EmbeddedSystemClass/dynamometer/README.md

# dynamometer
Electric winch two motor testing 

Two motors are coupled via a Gates belt.  One motor operates in torque mode and the other acts as a regenerative brake in speed mode.  The battery bank supplies power to make up for losses.  Other instrumentation measures drive belt tension, and inverter currents, etc.

This project clones many of the routines developed in the 'mxusartusbcan' project, and uses STM32CubeMX with FreeRTOS on a DiscoveryF4 board connected to other hardware interfaces.
