EmbeddedSystemClass/dynamometer/Ourwares/adcsetup.ods

 | mxusartusbcan |  | From datasheet formula
 | adc setup |  | Section | 5.3.21
 | 02/02/19 |  | 12-bit ADC | characteristics
 |  | Bus | 84
 |  | Divider | 8
 | K(sampling) | C(pf) | fadc*MHz) | 12bit | Rain |  | Sample tiime
 | 3 | 5 | 10.5 | 9.7040605278 | 5.79 |  | 0.3
 | 15 | 5 | 10.5 | 9.7040605278 | 29.34 |  | 1.4
 | 28 | 5 | 10.5 | 9.7040605278 | 54.86 |  | 2.7
 | 56 | 5 | 10.5 | 9.7040605278 | 109.82 |  | 5.3 |  |  | cts/volt
 | 84 | 5 | 10.5 | 9.7040605278 | 164.78 |  | 8.0 |  |  | 819 | 2.5 | 2047.5 | 2047.5
 | 112 | 5 | 10.5 | 9.7040605278 | 219.74 |  | 10.7 |  |  |  | 2047 | 1842.3
 | 144 | 5 | 10.5 | 9.7040605278 | 282.55 |  | 13.7
dynamometer | 480 | 5 | 10.5 | 9.7040605278 | 942.07 |  | 45.7
'MX
03/15/19 |  |  | ADC | Sample cycles | conv (us) |  |  | Offset | divider | Sensor amps | scale
 | PA1 | IN1 | 1 | 56 | 6.4761904762 |  | spare | ADC cts |  |  | amps
 | PA5 | IN5 | 2 | 56 | 6.4761904762 |  | Total battery current | 2047 | 0.6444444444 | 200 | 0.1086 |  | ACS770ECB-200B-PFF-T
 | PA6 | IN6 | 3 | 56 | 6.4761904762 |  | Current #1 motor | 2047 | 0.6444444444 | 600 | 0.3257 |  | L01Z600S05
 | PA7 | IN7 | 4 | 56 | 6.4761904762 |  | Current #2 motor | 2047 | 0.6444444444 | 400 | 0.2172 |  | L01Z400S05
 | PB0 | IN8 | 5 | 56 | 6.4761904762 |  | Speed control pot
 | PC1 | IN11 | 6 | 56 | 6.4761904762 |  | Control level (Hall sensor)
 | PC2 | IN12 | 7 | 56 | 6.4761904762 |  | +12 volt supply raw | 0 | 0.1525423729 | 19.0111111111
 | PC5 | IN15 | 8 | 56 | 6.4761904762 |  | +5 sensor supply voltage | 0 | 0.5465116279 | 5.3063829787
 |  | Temp | 9 | 480 | 46.8571428571 |  | Internal temperature sensor
 |  | Vref | 10 | 480 | 46.8571428571 |  | Internal voltage reference
 |  |  | DMA buffer | Num seq | 16
 |  |  |  | Total size | 320 |  |  | 10 | 10 | 0.5000 | 2.5000
 |  |  |  |  |  |  |  | 8.2 | 10 | 0.5495 | 2.7473
 |  |  |  | Time per seq | 145.5238095238 |  |  | 6.8 | 10 | 0.5952 | 2.9762
 |  |  | DMA buffer | Num seq | 16 | Per ½ dma
 |  |  |  | Per dma | 2328.380952381 | 1164.1904761905
 |  |  |  |  | 858.9659685864
 |  |  |  |  | DMA interrupt
 |  |  |  |  | Per sec | us per
 |  |  |  |  | 859 | 1164.1443538999
