EmbeddedSystemClass/dynamometer/docs/manuals/DMOC Boot Information.docx

DMOC Boot Information

EEBoxConfig: CRC OK. Versions Match.

CBL-51NA-3041-001

EE Parameters: CRC OK. GUID match OK.

EE3 (Vars): CRC OK. GUID match OK.

EEBoxConfig: CRC OK. Versions Match.

Control at 1x switching frequency (10kHz).

Azure Transit Connect MY10.5 645 Liquid Cooled, Siemens 1PV5135

P1X-18FB-3047-010 Fri Oct 28 16:07:19 2011

Compiled by zsobhani from b_rel_0032 at R21756+

Hardware PN: CTR-010180-00K SN: 111018-006

GUID: 9D-C7-1C-F3-A0-B7-42-DD

DMoC Time is: 2018/05/31 22:52:57 GMT

................"""""""""""""""""""""""""""""""""


NOTE: DMOC serial parameters are 19200 8N1

Note the GUID is the same as for my first DMOC
