EmbeddedSystemClass/dynamometer/docs/schematics/CP State LEDs.sch

## EAGLE design docs/schematics/CP State LEDs.sch (2019-03-12)

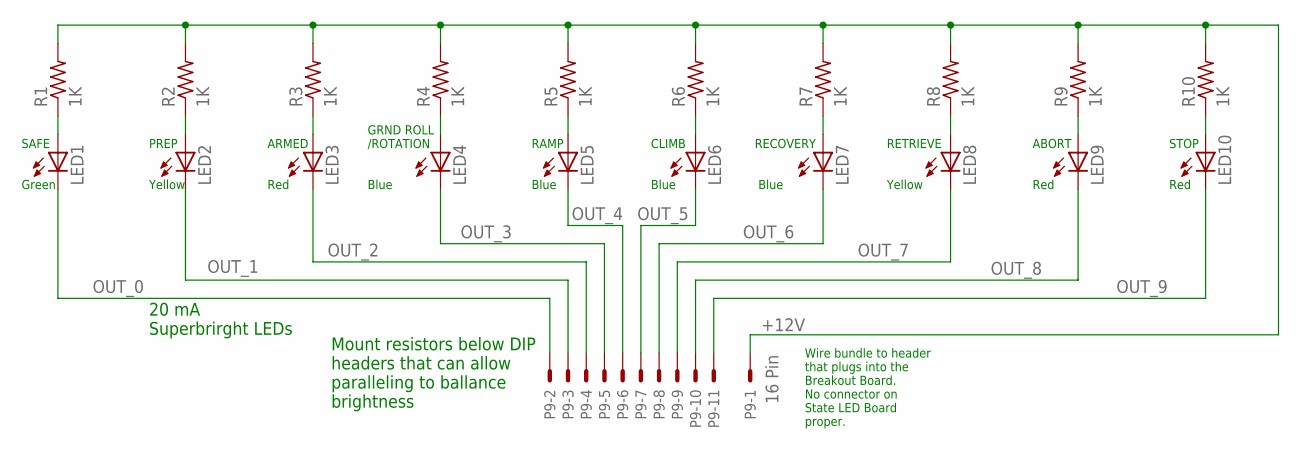
[picture p1: schematic CP State LEDs.sch]

Parts:
LED1, LED2, LED3, LED4, LED5, LED6, LED7, LED8, LED9, LED10: LED5MM
P9: 16 Pin; 70543-20
R1, R2, R3, R4, R5, R6, R7, R8, R9, R10: 1K; V234/12

Connections:
+12V: P9.1, R1.2, R2.2, R3.2, R4.2, R5.2, R6.2, R7.2, R8.2, R9.2, R10.2
unnamed: LED1.A, R1.1
unnamed: LED2.A, R2.1
unnamed: LED3.A, R3.1
unnamed: LED4.A, R4.1
unnamed: LED5.A, R5.1
unnamed: LED6.A, R6.1
unnamed: LED7.A, R7.1
unnamed: LED8.A, R8.1
unnamed: LED9.A, R9.1
unnamed: LED10.A, R10.1
OUT_0: LED1.K (C), P9.2
OUT_1: LED2.K (C), P9.3
OUT_2: LED3.K (C), P9.4
OUT_3: LED4.K (C), P9.5
OUT_4: LED5.K (C), P9.6
OUT_5: LED6.K (C), P9.7
OUT_6: LED7.K (C), P9.8
OUT_7: LED8.K (C), P9.9
OUT_8: LED9.K (C), P9.10
OUT_9: LED10.K (C), P9.11

Notes on the sheet:
SAFE Green
PREP Yellow
ARMED Red
GRND ROLL /ROTATION Blue
RAMP Blue
CLIMB Blue
RECOVERY Blue
RETRIEVE Yellow
ABORT Red
STOP Red
20 mA Superbrirght LEDs
Mount resistors below DIP headers that can allow paralleling to ballance brightness
Wire bundle to header that plugs into the Breakout Board. No connector on State LED Board proper.
