EmbeddedSystemClass/dynamometer/docs/schematics/Control Panel High Level.sch

## EAGLE design docs/schematics/Control Panel High Level.sch (2019-03-12)

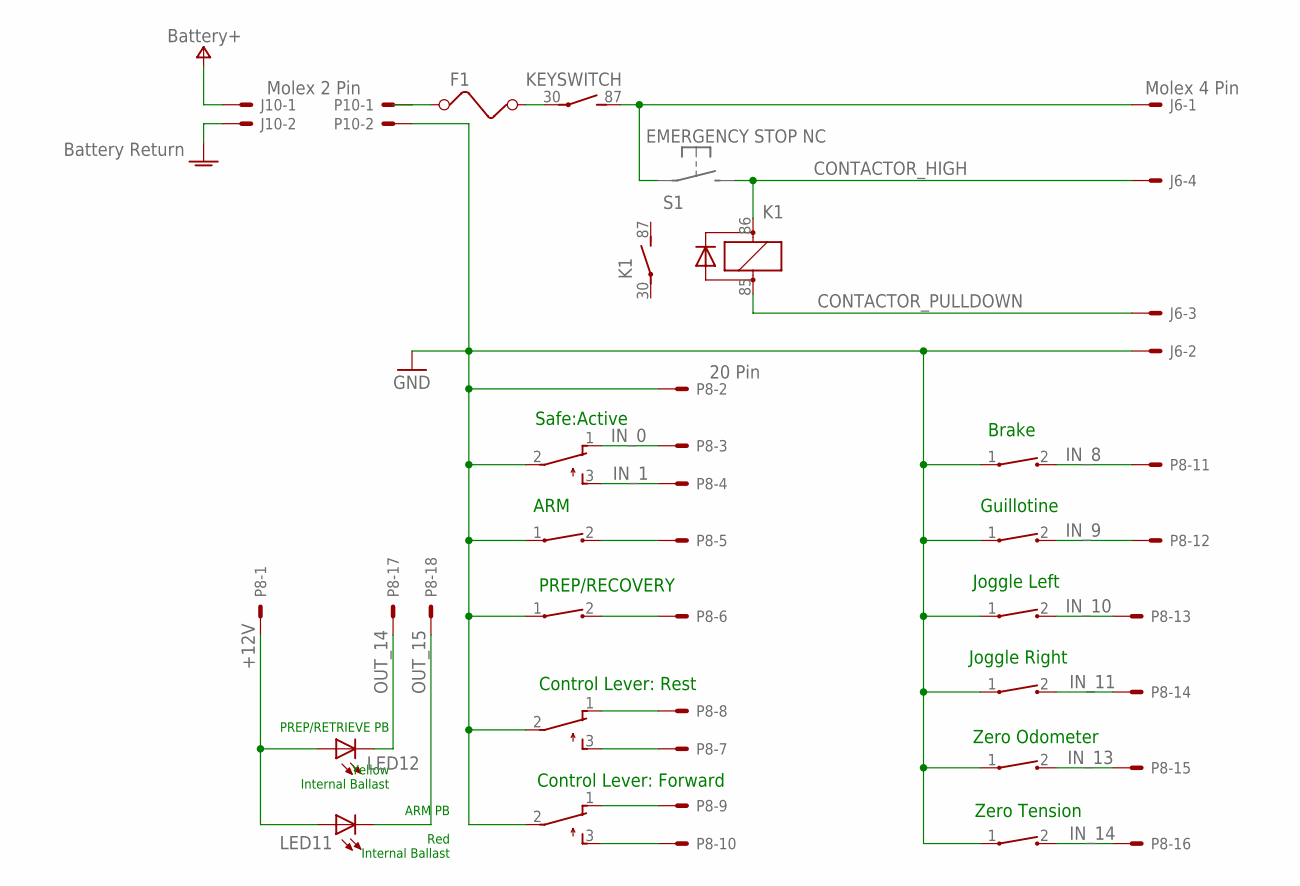
[picture p2: schematic Control Panel High Level.sch]

Parts:
F1: FUSE
J6: Molex 4 Pin; 22-23-2041
J10: 22-23-2021
K1: CB1-D-P-12V; CB1
KEYSWITCH: Starter Relay; CB1
LED11, LED12: LED5MM
P8: 20 Pin; 70543-20
P10: Molex 2 Pin; 22-23-2021
S2, S3, S8: TL32PO; TL3XPO
SW1, SW2, SW3, SW4, SW7, SW8, SW9, SW10: CT10-XXXX-A2

Connections:
+12V: LED11.A, LED12.A, P8.1
BATTERY+: J10.1
CONTACTOR_HIGH: J6.4, K1.86 (+)
CONTACTOR_PULLDOWN: J6.3, K1.85 (-)
GND: J6.2, P8.2, P10.2, S2.2, S3.2, S8.2, SW1.1, SW2.1, SW3.1, SW4.1, SW7.1, SW8.1, SW9.1, SW10.1
GNDA: J10.2
IN_0: P8.3, S8.1 (O)
IN_1: P8.4, S8.3 (S)
IN_8: P8.11, SW7.2
IN_9: P8.12, SW8.2
IN_10: P8.13, SW9.2
IN_11: P8.14, SW10.2
IN_13: P8.15, SW2.2
IN_14: P8.16, SW1.2
unnamed: F1.2, KEYSWITCH.30
unnamed: J6.1, KEYSWITCH.87 (S)
unnamed: F1.1, P10.1
unnamed: P8.10, S3.3 (S)
unnamed: P8.9, S3.1 (O)
unnamed: P8.8, S2.1 (O)
unnamed: P8.7, S2.3 (S)
unnamed: P8.6, SW4.2
unnamed: P8.5, SW3.2
OUT_14: LED12.K (C), P8.17
OUT_15: LED11.K (C), P8.18

Notes on the sheet:
Control Lever: Forward
Control Lever: Rest
PREP/RECOVERY
ARM
Zero Odometer
Zero Tension
Joggle Left
Joggle Right
Brake
Guillotine
Safe:Active
ARM PB Red Internal Ballast
PREP/RETRIEVE PB Yellow Internal Ballast
