EmbeddedSystemClass/dynamometer/docs/schematics/MC Breakout-F4 & Power.sch

## EAGLE design docs/schematics/MC Breakout-F4 & Power.sch (2019-03-12)

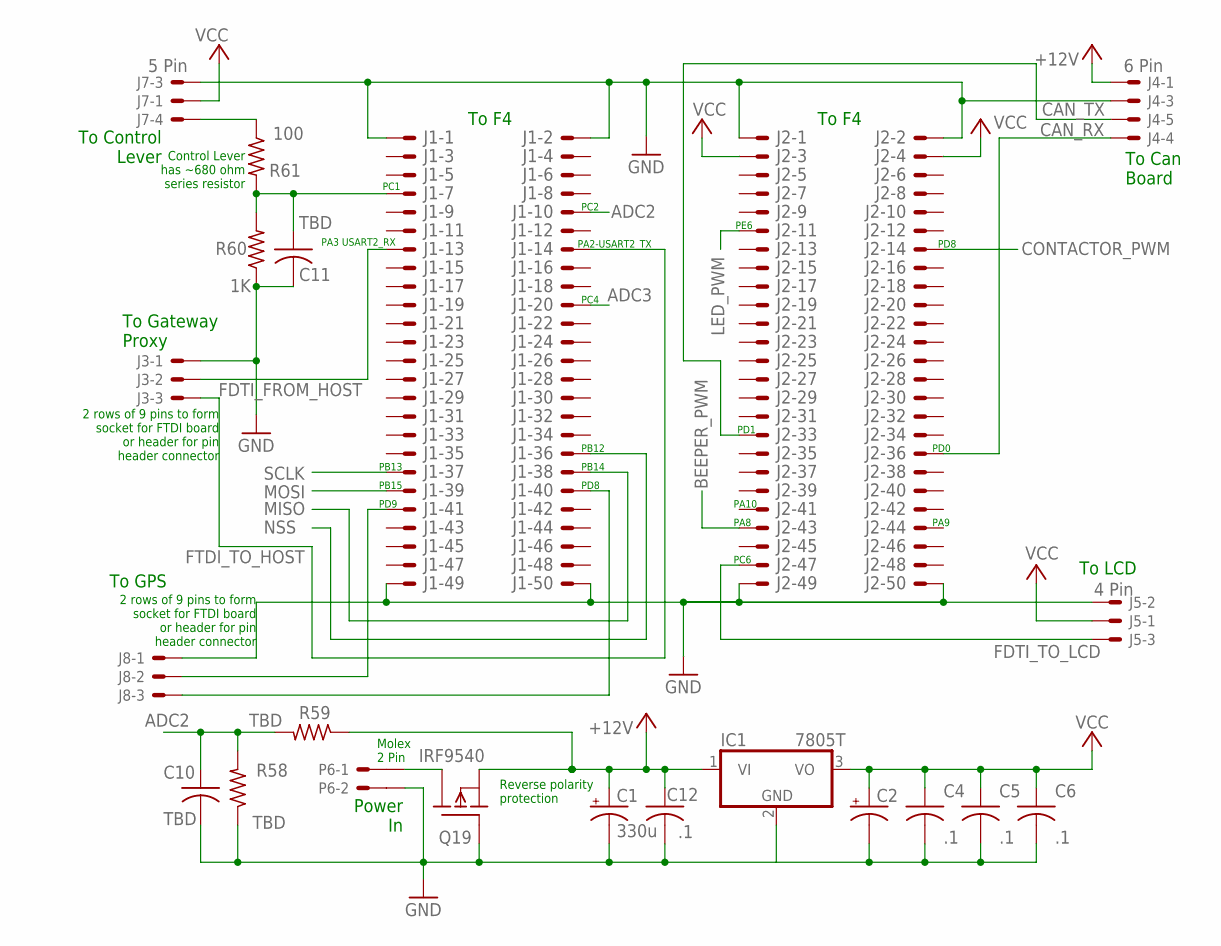
[picture p3: schematic MC Breakout-F4 & Power.sch]

Parts:
C1: 330u; E2-5
C2: CPOL-USE2-5; E2-5
C4, C5, C6, C12: .1; SMT0805
C10, C11: TBD; SMT0805
IC1: 7805T; TO220H
J1, J2: 1365-50
J3, J8: 22-23-2041
J4: 6 Pin; 22-23-2061
J5: 4 Pin; 22-23-2051
J7: 5 Pin; 22-23-2051
P6: 43160-3102; 43160-XX02
Q19: IRF9540; TO220
R58, R59: TBD; V234/12
R60: 1K; V234/12
R61: 100; V234/12

Connections:
+5V: C1.+, C12.P$1 (1), IC1.1 (VI), J4.1, Q19.3 (S), R59.1
ADC2: C10.P$1 (1), J1.10, R58.2, R59.2
ADC3: J1.20
ADC_1: C11.P$1 (1), J1.7, R60.2, R61.2
BEEPER_PWM: J2.43
CAN_RX: J2.36, J4.4
CAN_TX: J2.33, J4.5
CONTACTOR_PWM: J2.14
CONTROL_LEVER: J7.4, R61.1
FDTI_FROM_HOST: J3.3
FDTI_FROM_HOST1: J1.40, J8.3
FDTI_TO_LCD: J2.47, J5.3
FLYBACK_RTN: P6.1@1, Q19.2 (D)
FTDI_TO_HOST: J3.2
FTDI_TO_HOST1: J1.41, J8.2
GND: C1.-, C2.-, C4.P$2 (2), C5.P$2 (2), C6.P$2 (2), C10.P$2 (2), C11.P$2 (2), C12.P$2 (2), IC1.2 (GND), J1.1, J1.2, J1.49, J1.50, J2.1, J2.2, J2.49, J2.50, J3.1, J4.3, J5.2, J7.3, J8.1, P6.2@1, Q19.1 (G), R58.1, R60.1
LED_PWM: J2.11
MISO: J1.38
MOSI: J1.39
NSS: J1.36
SCLK: J1.37
VCC: C2.+, C4.P$1 (1), C5.P$1 (1), C6.P$1 (1), IC1.3 (VO), J2.3, J2.4, J5.1, J7.1

Notes on the sheet:
To F4
To Can Board
To Gateway Proxy
To Control Lever
To LCD
Power In
Molex 2 Pin
Reverse polarity protection
Control Lever has ~680 ohm series resistor
PB13
PC1
PB15
PB14
PD8
PA8
PA10
PA9
PC4
PC2
PD0
PE6
PD1
PA2-USART2_TX
PA3 USART2_RX
PD9
PC6
To GPS
2 rows of 9 pins to form socket for FTDI board or header for pin header connector
PB12
