EmbeddedSystemClass/dynamometer/docs/schematics/MC Brekout-SPInew.sch

## EAGLE design docs/schematics/MC Brekout-SPInew.sch (2019-03-12)

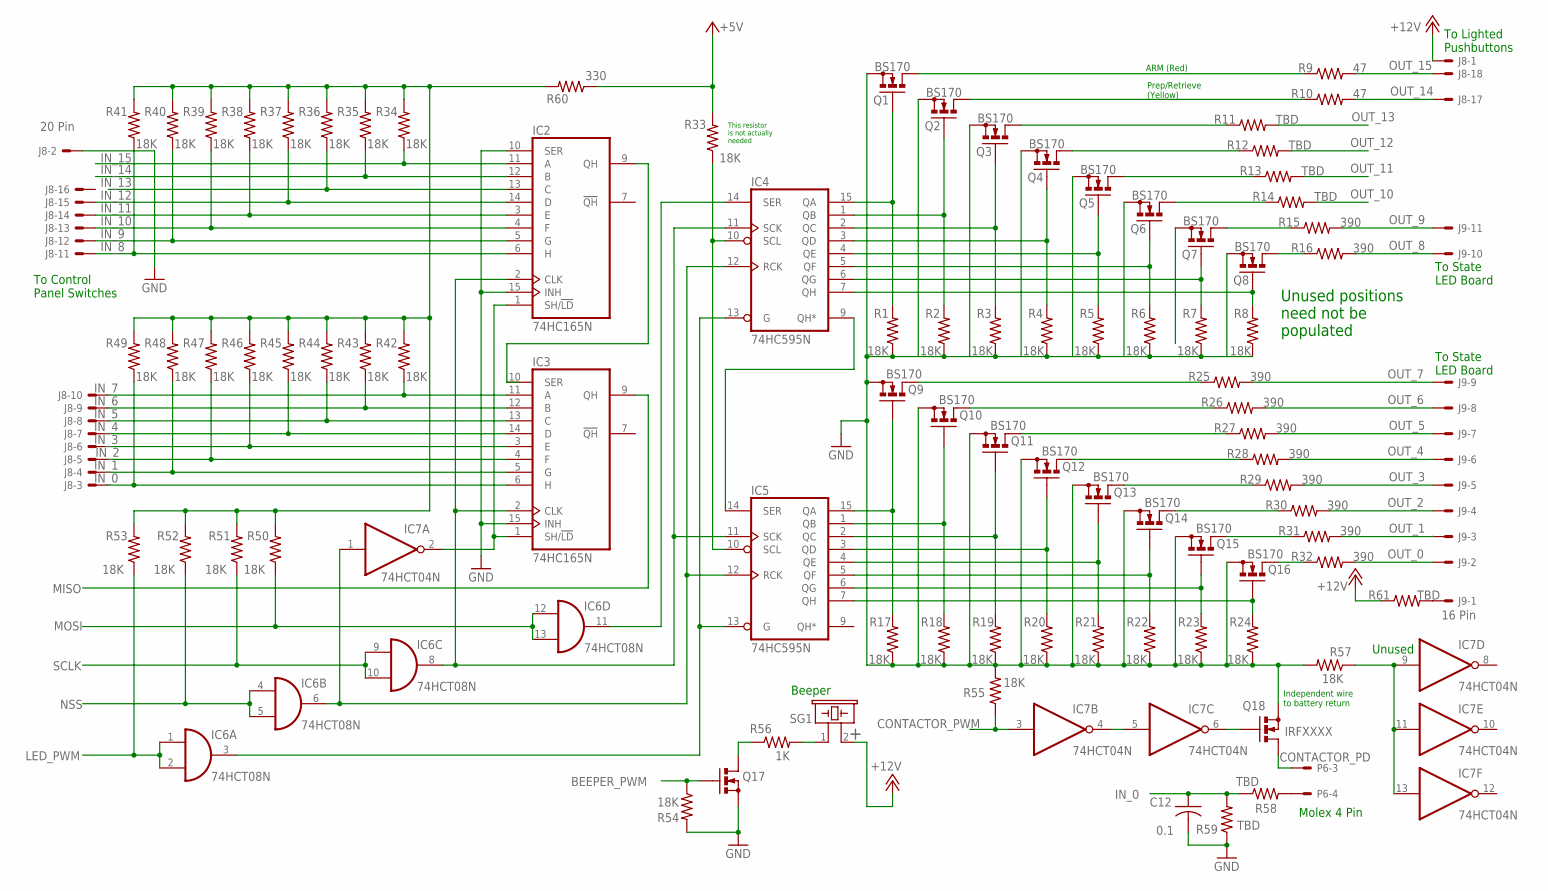
[picture p4: schematic MC Brekout-SPInew.sch]

Parts:
C12: 0.1; SMT0805
IC2, IC3: 74HC165N; DIL16
IC4, IC5: 74HC595N; DIL16
IC6: 74HCT08N; DIL14
IC7: 74HCT04N; DIL14
J8: 20 Pin; 70543-20
J9: 16 Pin; 22-23-2121
P6: Molex 4 Pin; 22-23-2041
Q1, Q2, Q3, Q4, Q5, Q6, Q7, Q8, Q9, Q10, Q11, Q12, Q13, Q14, Q15, Q16, Q17: BS170; SOT54E
Q18: IRFXXXX; SOT54E
R1, R2, R3, R4, R5, R6, R7, R8, R17, R18, R19, R20, R21, R22, R23, R24, R33, R34, R35, R36, R37, R38, R39, R40, R41, R42, R43, R44, R45, R46, R47, R48, R49, R50, R51, R52, R53, R54, R55, R57: 18K; V234/12
R9, R10: 47; V234/12
R11, R12, R13, R14, R58, R59, R61: TBD; V234/12
R15, R16, R25, R26, R27, R28, R29, R30, R31, R32: 390; V234/12
R56: 1K; V234/12
R60: 330; V234/12
SG1: EFBAA40D101

Connections:
+5V: R33.2, R60.1
+12V: J8.1, R61.1, SG1.2
BEEPER_PWM: Q17.G, R54.1
CONTACTOR_PD: P6.3, Q18.D
CONTACTOR_PWM: IC7.3 (I), R55.1
GND: C12.P$2 (2), IC2.10 (SER), IC2.15 (INH), IC3.15 (INH), J8.2, Q1.S, Q9.S, Q10.S, Q11.S, Q12.S, Q13.S, Q14.S, Q15.S, Q16.S, Q17.S, Q18.S, R1.1, R2.1, R3.1, R4.1, R5.1, R6.1, R7.1, R8.1, R17.1, R18.1, R19.1, R20.1, R21.1, R22.1, R23.1, R24.1, R54.2, R55.2, R57.2, R59.1
IN_0: C12.P$1 (1), IC3.6 (H), J8.3, R49.1, R58.1, R59.2
IN_1: IC3.5 (G), J8.4, R48.1
IN_2: IC3.4 (F), J8.5, R47.1
IN_3: IC3.3 (E), J8.6, R46.1
IN_4: IC3.14 (D), J8.7, R45.1
IN_5: IC3.13 (C), J8.8, R44.1
IN_6: IC3.12 (B), J8.9, R43.1
IN_7: IC3.11 (A), J8.10, R42.1
IN_8: IC2.6 (H), J8.11, R41.1
IN_9: IC2.5 (G), J8.12, R40.1
IN_10: IC2.4 (F), J8.13, R39.1
IN_11: IC2.3 (E), J8.14, R38.1
IN_12: IC2.14 (D), J8.15, R37.1
IN_13: IC2.13 (C), R36.1
IN_14: IC2.12 (B), R35.1
IN_15: IC2.11 (A), R34.1
LED_PWM: IC6.1 (I0), IC6.2 (I1), R53.1
MISO: IC3.9 (QH)
MOSI: IC6.12 (I0), IC6.13 (I1), R50.1
unnamed: P6.4, R58.2
unnamed: IC4.1 (QB), Q2.G, R2.2
unnamed: IC4.2 (QC), Q3.G, R3.2
unnamed: IC4.3 (QD), Q4.G, R4.2
unnamed: IC4.4 (QE), Q5.G, R5.2
unnamed: IC5.1 (QB), Q10.G, R18.2
unnamed: IC4.6 (QG), Q7.G, R7.2
unnamed: IC4.7 (QH), Q8.G, R8.2
unnamed: Q1.D, R9.1
unnamed: Q2.D, R10.1
unnamed: Q3.D, R11.1
unnamed: Q4.D, R12.1
unnamed: Q5.D, R13.1
unnamed: Q6.D, R14.1
unnamed: Q7.D, R15.1
unnamed: Q8.D, R16.1
unnamed: IC4.9 (QH*), IC5.14 (SER)
unnamed: IC5.2 (QC), Q11.G, R19.2
unnamed: IC5.3 (QD), Q12.G, R20.2
unnamed: IC7.9 (I), IC7.11 (I), IC7.13 (I), R57.1
unnamed: R56.2, SG1.1
unnamed: IC4.5 (QF), Q6.G, R6.2
unnamed: IC4.15 (QA), Q1.G, R1.2
unnamed: IC5.4 (QE), Q13.G, R21.2
unnamed: IC5.6 (QG), Q15.G, R23.2
unnamed: IC5.7 (QH), Q16.G, R24.2
unnamed: Q9.D, R25.1
unnamed: Q10.D, R26.1
unnamed: Q11.D, R27.1
unnamed: Q12.D, R28.1
unnamed: Q13.D, R29.1
unnamed: Q14.D, R30.1
unnamed: Q15.D, R31.1
unnamed: IC2.9 (QH), IC3.10 (SER)
unnamed: Q16.D, R32.1
unnamed: IC5.5 (QF), Q14.G, R22.2
unnamed: IC5.15 (QA), Q9.G, R17.2
unnamed: Q17.D, R56.1
unnamed: IC7.4 (O), IC7.5 (I)
unnamed: IC7.6 (O), Q18.G
unnamed: IC2.1 (SH/!LD), IC3.1 (SH/!LD), IC7.2 (O)
unnamed: R34.2, R35.2, R36.2, R37.2, R38.2, R39.2, R40.2, R41.2, R42.2, R43.2, R44.2, R45.2, R46.2, R47.2, R48.2, R49.2, R50.2, R51.2, R52.2, R53.2, R60.2
unnamed: J9.1, R61.2
unnamed: IC2.2 (CLK), IC3.2 (CLK), IC4.11 (SCK), IC5.11 (SCK), IC6.8 (O)
unnamed: IC4.14 (SER), IC6.11 (O)
unnamed: IC4.10 (SCL), IC5.10 (SCL), R33.1
unnamed: IC4.12 (RCK), IC5.12 (RCK), IC6.6 (O), IC7.1 (I)
unnamed: IC4.13 (G), IC5.13 (G), IC6.3 (O)
NSS: IC6.4 (I0), IC6.5 (I1), R52.1
OUT_0: J9.2, R32.2
OUT_1: J9.3, R31.2
OUT_2: J9.4, R30.2
OUT_3: J9.5, R29.2
OUT_4: J9.6, R28.2
OUT_5: J9.7, R27.2
OUT_6: J9.8, R26.2
OUT_7: J9.9, R25.2
OUT_8: J9.10, R16.2
OUT_9: J9.11, R15.2
OUT_10: R14.2
OUT_11: R13.2
OUT_12: R12.2
OUT_13: R11.2
OUT_14: J8.17, R10.2
OUT_15: J8.18, R9.2
SCLK: IC6.9 (I0), IC6.10 (I1), R51.1

Notes on the sheet:
Unused
Independent wire to battery return
To State LED Board
To Lighted Pushbuttons
Molex 4 Pin
Beeper
This resistor is not actually needed
To Control Panel Switches
Unused positions need not be populated
ARM (Red)
Prep/Retrieve (Yellow)
