EmbeddedSystemClass/dynamometer/Src/main.c

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

/* Includes ------------------------------------------------------------------*/
#include "main.h"
#include "cmsis_os.h"
#include "usb_device.h"

/* USER CODE BEGIN Includes */
#include <string.h>
#include "SerialTaskSend.h"
#include "stm32f4xx_hal_pcd.h"
#include "usbd_cdc_if.h"
#include "cdc_txbuff.h"
#include "CanTask.h"
#include "can_iface.h"
#include "canfilter_setup.h"
#include "stm32f4xx_hal_can.h"
#include "getserialbuf.h"
#include "stackwatermark.h"
#include "yprintf.h"
#include "gateway_comm.h"
#include "gateway_CANtoPC.h"
#include "DTW_counter.h"
#include "SerialTaskReceive.h"
#include "yscanf.h"
#include "adctask.h"
#include "ADCTask.h"
#include "adcparams.h"
#include "adcparamsinit.h"
#include "gateway_PCtoCAN.h"
#include "morse.h"
#include "MailboxTask.h"
#include "GatewayTask.h"
#include "iir_f2.h"

/* USER CODE END Includes */

/* USER CODE BEGIN PTD */
#define CONFIGCAN2	// Do initializations for CAN2

void* verr[8];
uint32_t verrx = 0;
__attribute__( ( always_inline ) ) __STATIC_INLINE uint32_t __get_SP(void) 
{ 
  register uint32_t result; 

  __ASM volatile ("MOV %0, SP\n" : "=r" (result) ); 
  return(result); 
} 

uint32_t timectr = 0;
struct CAN_CTLBLOCK* pctl0;	// Pointer to CAN1 control block
struct CAN_CTLBLOCK* pctl1;	// Pointer to CAN2 control block

uint32_t debugTX1b;
uint32_t debugTX1b_prev;

uint32_t debugTX1c;
uint32_t debugTX1c_prev;

uint32_t debug03;
uint32_t debug03_prev;

extern osThreadId SerialTaskHandle;
extern osThreadId CanTxTaskHandle;
extern osThreadId CanRxTaskHandle;
extern osThreadId SerialTaskReceiveHandle;
extern osThreadId GatewayTaskHandle;

uint8_t canflag;
uint8_t canflag1;
uint8_t canflag2;

/* USER CODE END PTD */

ADC_HandleTypeDef hadc1;
DMA_HandleTypeDef hdma_adc1;

CAN_HandleTypeDef hcan1;
CAN_HandleTypeDef hcan2;

UART_HandleTypeDef huart2;
UART_HandleTypeDef huart6;
DMA_HandleTypeDef hdma_usart2_rx;
DMA_HandleTypeDef hdma_usart2_tx;
DMA_HandleTypeDef hdma_usart6_rx;
DMA_HandleTypeDef hdma_usart6_tx;

osThreadId defaultTaskHandle;
osTimerId defaultTaskTimerHandle;
osTimerId defautTaskTimer01Handle;
void SystemClock_Config(void);
static void MX_GPIO_Init(void);
static void MX_DMA_Init(void);
static void MX_USART6_UART_Init(void);
static void MX_USART2_UART_Init(void);
static void MX_CAN1_Init(void);
static void MX_CAN2_Init(void);
static void MX_ADC1_Init(void);
void StartDefaultTask(void const * argument);
void CallbackdefaultTaskTimer(void const * argument);
void CallbackdefaultTaskTimer01(void const * argument);

/**
  * @brief  The application entry point.
  * @retval int
  */
int main(void)
{
  /* USER CODE BEGIN 1 */
	BaseType_t ret;	   // Used for returns from function calls
	osMessageQId Qidret; // Functin call return
  /* USER CODE END 1 */

  /* MCU Configuration--------------------------------------------------------*/

  /* Reset of all peripherals, Initializes the Flash interface and the Systick. */
  HAL_Init();

  /* USER CODE BEGIN Init */
	DTW_counter_init();
  /* USER CODE END Init */

  /* Configure the system clock */
  SystemClock_Config();

  /* Initialize all configured peripherals */
  MX_GPIO_Init();
  MX_DMA_Init();
  MX_USART6_UART_Init();
  MX_USART2_UART_Init();
  MX_CAN1_Init();
  MX_CAN2_Init();
  MX_ADC1_Init();
  /* USER CODE BEGIN 2 */
/*
DiscoveryF4 LEDs --
 GPIOD, GPIO_PIN_12 GREEN
 GPIOD, GPIO_PIN_13 ORANGE
 GPIOD, GPIO_PIN_14 RED
 GPIOD, GPIO_PIN_15 BLUE
*/


  /* USER CODE END 2 */

  /* USER CODE BEGIN RTOS_MUTEX */
  /* add mutexes, ... */
  /* USER CODE END RTOS_MUTEX */

  /* USER CODE BEGIN RTOS_SEMAPHORES */
  /* add semaphores, ... */
  /* USER CODE END RTOS_SEMAPHORES */

  /* Create the timer(s) */
  /* definition and creation of defaultTaskTimer */
  osTimerDef(defaultTaskTimer, CallbackdefaultTaskTimer);
  defaultTaskTimerHandle = osTimerCreate(osTimer(defaultTaskTimer), osTimerPeriodic, NULL);

  /* definition and creation of defautTaskTimer01 */
  osTimerDef(defautTaskTimer01, CallbackdefaultTaskTimer01);
  defautTaskTimer01Handle = osTimerCreate(osTimer(defautTaskTimer01), osTimerPeriodic, NULL);

  /* USER CODE BEGIN RTOS_TIMERS */
  /* start timers, add new ones, ... */

	/* defaultTask timer for pacing display of stack usages. */
	ret = xTimerChangePeriod( defaultTaskTimerHandle  ,pdMS_TO_TICKS(5000),0);
	/* defaultTask timer for pacing ADC monitoring. */
	ret = xTimerChangePeriod( defautTaskTimer01Handle,pdMS_TO_TICKS(1000),0);

  /* USER CODE END RTOS_TIMERS */

  /* Create the thread(s) */
  /* definition and creation of defaultTask */
  osThreadDef(defaultTask, StartDefaultTask, osPriorityLow, 0, 384);
  defaultTaskHandle = osThreadCreate(osThread(defaultTask), NULL);

  /* USER CODE BEGIN RTOS_THREADS */
  /* add threads, ... */
/* =================================================== */
	/* Create serial task (priority) */
	// Task handle "osThreadId SerialTaskHandle" is global
	xSerialTaskSendCreate(0);	// Create task and set Task priority

	/* Add bcb circular buffer to SerialTaskSend for usart6 */
	#define NUMCIRBCB6  16 // Size of circular buffer of BCB for usart6
	ret = xSerialTaskSendAdd(&huart6, NUMCIRBCB6, 0); // char-by-char
	if (ret < 0) morse_trap(1); // Panic LED flashing

	/* Add bcb circular buffer to SerialTaskSend for usart2 */
	#define NUMCIRBCB2  16 // Size of circular buffer of BCB for usart2
	ret = xSerialTaskSendAdd(&huart2, NUMCIRBCB2, 1); // dma
	if (ret < 0) morse_trap(2); // Panic LED flashing

	/* Setup semaphore for yprint and sprintf et al. */
	yprintf_init();

	/* Create serial receiving task. */
	xSerialTaskReceiveCreate(0);

	/* USB-CDC buffering */
	#define NUMCDCBUFF 3	// Number of CDC task local buffers
	#define CDCBUFFSIZE 64*16	// Best buff size is multiples of usb packet size
	struct CDCBUFFPTR* pret;
	pret = cdc_txbuff_init(NUMCDCBUFF, CDCBUFFSIZE); // Setup local buffers
	if (pret == NULL) morse_trap(3);
	
	/* USB-CDC queue and task creation */
	Qidret = xCdcTxTaskSendCreate(3);
	if (Qidret < 0) morse_trap(4); // Maybe add panic led flashing here

  /* definition and creation of CanTxTask - CAN driver TX interface. */
  Qidret = xCanTxTaskCreate(0, 32); // CanTask priority, Number of msgs in queue
	if (Qidret < 0) morse_trap(5); // Panic LED flashing

  /* definition and creation of CanRxTask - CAN driver RX interface. */
//  Qidret = xCanRxTaskCreate(1, 32); // CanTask priority, Number of msgs in queue
//	if (Qidret < 0) morse_trap(6); // Panic LED flashing

	/* Setup TX linked list for CAN  */
   // CAN1 (CAN_HandleTypeDef *phcan, uint8_t canidx, uint16_t numtx, uint16_t numrx);
	pctl0 = can_iface_init(&hcan1, 0, 32, 64);
	if (pctl0 == NULL) morse_trap(7); // Panic LED flashing
	if (pctl0->ret < 0) morse_trap(77);

	// CAN 2
#ifdef CONFIGCAN2
	pctl1 = can_iface_init(&hcan2, 1,32, 64);
	if (pctl1 == NULL) morse_trap(8); // Panic LED flashing
	if (pctl1->ret < 0) morse_trap(88);
#endif

	/* Setup CAN hardware filters to default to accept all ids. */
	HAL_StatusTypeDef Cret;
	Cret = canfilter_setup_first(0, &hcan1, 15); // CAN1
	if (Cret == HAL_ERROR) morse_trap(9);

#ifdef CONFIGCAN2
	Cret = canfilter_setup_first(1, &hcan2, 15); // CAN2
	if (Cret == HAL_ERROR) morse_trap(10);
#endif

	/* Remove "accept all" CAN msgs and add specific id & mask, or id here. */
	// See canfilter_setup.h

	/* Create MailboxTask */
	xMailboxTaskCreate(2);

	/* Create GatewayTask */
	xGatewayTaskCreate(1);

	/* Create Mailbox control block w 'take' pointer for each CAN module. */
	struct MAILBOXCANNUM* pmbxret;
	// (CAN1 control block pointer, size of circular buffer)
	pmbxret = MailboxTask_add_CANlist(pctl0, 48);
	if (pmbxret == NULL) morse_trap(16);

	// (CAN2 control block pointer, size of circular buffer)
	MailboxTask_add_CANlist(pctl1, 48); // Use default buff size
	if (pmbxret == NULL) morse_trap(17);

	/* Further initialization of mailboxes takes place when tasks start */

	/* Select interrupts for CAN1 */
	HAL_CAN_ActivateNotification(&hcan1, \
		CAN_IT_TX_MAILBOX_EMPTY     |  \
		CAN_IT_RX_FIFO0_MSG_PENDING |  \
		CAN_IT_RX_FIFO1_MSG_PENDING    );

	/* Select interrupts for CAN2 */
#ifdef CONFIGCAN2
	HAL_CAN_ActivateNotification(&hcan2, \
		CAN_IT_TX_MAILBOX_EMPTY     |  \
		CAN_IT_RX_FIFO0_MSG_PENDING |  \
		CAN_IT_RX_FIFO1_MSG_PENDING    );
#endif

	/* Start CANs */
	HAL_CAN_Start(&hcan1); // CAN1
#ifdef CONFIGCAN2
	HAL_CAN_Start(&hcan2); // CAN2
#endif

	/* ADC summing, calibration, etc. */
	xADCTaskCreate(3);

/* =================================================== */

  /* USER CODE END RTOS_THREADS */

  /* USER CODE BEGIN RTOS_QUEUES */
  /* add queues, ... */

  /* USER CODE END RTOS_QUEUES */
 

  /* Start scheduler */
  osKernelStart();
  
  /* We should never get here as control is now taken by the scheduler */

  /* Infinite loop */
  /* USER CODE BEGIN WHILE */
  while (1)
  {
    /* USER CODE END WHILE */

    /* USER CODE BEGIN 3 */
  }
  /* USER CODE END 3 */
}

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
/* USER CODE BEGIN Header_StartDefaultTask */
/**
  * @brief  Function implementing the defaultTask thread.
  * @param  argument: Not used 
  * @retval None
  */
/* USER CODE END Header_StartDefaultTask */
void StartDefaultTask(void const * argument)
{
  /* init code for USB_DEVICE */
  MX_USB_DEVICE_Init();

  /* USER CODE BEGIN 5 */

// ::::::::::::::::::::::::::
float out;
float in = 1;//4095;
float z1 = 0;
float z2 = 0;
double outf;

float KK =   0.08033129;//(0.02008282*4.0);
float b1 = -1.5609759;
float b2 = -0.64130712;

int ict = 0;

struct FILTERIIRF2 iir2;
iir_f2_coefficients(&iir2, 0.05, 0.707, 0);
// ::::::::::::::::::::::::::

	int i;

	#define DEFAULTTSKBIT00	(1 << 0)  // Task notification bit for sw timer: stackusage
	#define DEFAULTTSKBIT01	(1 << 1)  // Task notification bit for sw timer: something else

	/* A notification copies the internal notification word to this. */
	uint32_t noteval = 0;    // Receives notification word upon an API notify

	/* notification bits processed after a 'Wait. */
	uint32_t noteused = 0;

	struct SERIALSENDTASKBCB* pbuf1 = getserialbuf(&huart6,96);
	if (pbuf1 == NULL) morse_trap(11);

	struct SERIALSENDTASKBCB* pbuf3 = getserialbuf(&huart6,96);
	if (pbuf1 == NULL) morse_trap(13);

	struct SERIALSENDTASKBCB* pbuf2 = getserialbuf(&huart6,96);
	if (pbuf1 == NULL) morse_trap(12);

	struct SERIALSENDTASKBCB* pbuf4 = getserialbuf(&huart6,96);
	if (pbuf1 == NULL) morse_trap(12);

	int ctr = 0; // Running count
	uint32_t heapsize;

	/* Test CAN msg */
	struct CANTXQMSG testtx;
	testtx.pctl = pctl0;
	testtx.can.id = 0xc2200000;
	testtx.can.dlc = 8;
	for (i = 0; i < 8; i++)
		testtx.can.cd.uc[i] = 0x30 + i;
	testtx.maxretryct = 8;
	testtx.bits = 0;

HAL_GPIO_TogglePin(GPIOD,GPIO_PIN_15); // BLUE LED

	uint32_t dmact_prev = adcommon.dmact;

extern volatile uint32_t adcdbg2;

// ::::::::::::::::::::::::::::::::::::::::::
		yprintf(&pbuf3,"\n\n\rIIR2: b1 %14.8f b2 %14.8f gain %14.8f\n\r",iir2.b1, iir2.b2,iir2.gain);
// ::::::::::::::::::::::::::::::::::::::::::

	for ( ;; )
	{
		xTaskNotifyWait(noteused, 0, &noteval, portMAX_DELAY);
		noteused = 0;
		if ((noteval & DEFAULTTSKBIT00) != 0)
		{
			noteused |= DEFAULTTSKBIT00;

			/* Display the amount of unused stack space for tasks. */
			yprintf(&pbuf2,"\n\r%4i Unused Task stack space--", ctr++);
			stackwatermark_show(defaultTaskHandle,&pbuf2,"defaultTask--");
			stackwatermark_show(SerialTaskHandle ,&pbuf2,"SerialTask---");
			stackwatermark_show(CanTxTaskHandle  ,&pbuf2,"CanTxTask----");
	//		stackwatermark_show(CanRxTaskHandle  ,&pbuf2,"CanRxTask----");
			stackwatermark_show(MailboxTaskHandle,&pbuf2,"MailboxTask--");
			stackwatermark_show(ADCTaskHandle    ,&pbuf2,"ADCTask------");
			stackwatermark_show(SerialTaskReceiveHandle,&pbuf2,"SerialRcvTask");
			stackwatermark_show(GatewayTaskHandle,&pbuf2,"GatewayTask--");

			/* Heap usage (and test fp woking. */
			heapsize = xPortGetFreeHeapSize();
			yprintf(&pbuf3,"\n\rGetFreeHeapSize: total: %i used %i %3.1f%% free: %i",configTOTAL_HEAP_SIZE, heapsize,\
				100.0*(float)heapsize/configTOTAL_HEAP_SIZE,(configTOTAL_HEAP_SIZE-heapsize));

			/* ==== CAN MSG sending test ===== */
			/* Place test CAN msg to send on queue in a burst. */
			/* Note: an odd makes the LED flash since it toggles on each msg. */
			for (i = 0; i < 7; i++)
				xQueueSendToBack(CanTxQHandle,&testtx,portMAX_DELAY);
		}
		if ((noteval & DEFAULTTSKBIT01) != 0)
		{
			noteused |= DEFAULTTSKBIT01;
		HAL_GPIO_TogglePin(GPIOD,GPIO_PIN_15); // BLUE LED
			yprintf(&pbuf2,"\n\rADC: Vdd: %7.4f %8.4f   Temp: %6.1f %6.1f %i",adcommon.fvdd,adcommon.fvddfilt,adcommon.degC,adcommon.degCfilt,(adcommon.dmact-dmact_prev));
			dmact_prev = adcommon.dmact;

			yprintf(&pbuf4,"\n\r 3:   %d %d %d\n\r 5:   %d %7.4f %7.4f %7.1f",\
                 adc1data.adcs1sum[ADC1IDX_INTERNALVREF]/ADC1DMANUMSEQ, adcommon.ivdd, adcdbg2,\
                 adc1data.adcs1sum[ADC1IDX_5VOLTSUPPLY ]/ADC1DMANUMSEQ, adcommon.f5_Vddratio, adcommon.f5vsupply,adcommon.f5vsupplyfilt);

			yprintf(&pbuf3,"\n\rR4: %d %7.2f %7.2f",	adc1data.adcs1sum[ADC1IDX_RESISRPOT]/ADC1DMANUMSEQ, adc1data.adc1calreading[ADC1IDX_RESISRPOT].f,\
                 adc1data.adc1calreadingfilt[ADC1IDX_RESISRPOT].f);

// ::::::::::::::::::::::::::::::::::::::::::
		 out = in + z1;
   	 z1  = z2 - b1 * out;
   	 z2  = b2 * out;
		outf = out * KK;
		yprintf(&pbuf2,"\n\rIIR2: %3i %14.8f %14.8f %12.8f",ict,z1,z2,outf);

		outf = iir_f2_f(&iir2, 1.0);
		yprintf(&pbuf4,"\n\rIIR2: %3i %14.8f %14.8f %12.8f",ict++,iir2.z1,iir2.z2,outf);

// ::::::::::::::::::::::::::::::::::::::::::

		}	
	}
  /* USER CODE END 5 */ 
}

/* CallbackdefaultTaskTimer function */
void CallbackdefaultTaskTimer(void const * argument)
{
  /* USER CODE BEGIN CallbackdefaultTaskTimer */
	BaseType_t xHigherPriorityTaskWoken = pdFALSE;
	xTaskNotifyFromISR(defaultTaskHandle, 
		DEFAULTTSKBIT00,	/* 'or' bit assigned to buffer to notification value. */
		eSetBits,      /* Set 'or' option */
		&xHigherPriorityTaskWoken ); 

  /* USER CODE END CallbackdefaultTaskTimer */
}

/* CallbackdefaultTaskTimer01 function */
void CallbackdefaultTaskTimer01(void const * argument)
{
  /* USER CODE BEGIN CallbackdefaultTaskTimer01 */
  	BaseType_t xHigherPriorityTaskWoken = pdFALSE;
	xTaskNotifyFromISR(defaultTaskHandle, 
		DEFAULTTSKBIT01,	/* 'or' bit assigned to buffer to notification value. */
		eSetBits,      /* Set 'or' option */
		&xHigherPriorityTaskWoken ); 
  /* USER CODE END CallbackdefaultTaskTimer01 */
}

/**
  * @brief  Period elapsed callback in non blocking mode
  * @note   This function is called  when TIM5 interrupt took place, inside
  * HAL_TIM_IRQHandler(). It makes a direct call to HAL_IncTick() to increment
  * a global variable "uwTick" used as application time base.
  * @param  htim : TIM handle
  * @retval None
  */
void HAL_TIM_PeriodElapsedCallback(TIM_HandleTypeDef *htim)
{
  if (htim->Instance == TIM5) {
    HAL_IncTick();
  }
}

/**
  * @brief  This function is executed in case of error occurrence.
  * @retval None
  */
void Error_Handler(void)
{
  /* USER CODE BEGIN Error_Handler_Debug */
  /* User can add his own implementation to report the HAL error return state */

  /* USER CODE END Error_Handler_Debug */
}

#ifdef  USE_FULL_ASSERT
/**
  * @brief  Reports the name of the source file and the source line number
  *         where the assert_param error has occurred.
  * @param  file: pointer to the source file name
  * @param  line: assert_param error line source number
  * @retval None
  */
void assert_failed(uint8_t *file, uint32_t line)
{ 
  /* USER CODE BEGIN 6 */
  /* User can add his own implementation to report the file name and line number,
     tex: printf("Wrong parameters value: file %s on line %d\r\n", file, line) */
  /* USER CODE END 6 */
}
#endif /* USE_FULL_ASSERT */

/************************ (C) COPYRIGHT STMicroelectronics *****END OF FILE****/
