EmbeddedSystemClass/dynamometer/dynamometer.ioc

Mcu.UserName=STM32F407VGTx
PA1.Signal=ADCx_IN1
PA11.Signal=USB_OTG_FS_DM
PA12.Signal=USB_OTG_FS_DP
PA2.Signal=USART2_TX
PA3.Signal=USART2_RX
PA5.Signal=ADCx_IN5
PA6.Signal=ADCx_IN6
PA7.Signal=ADCx_IN7
PB0.Signal=ADCx_IN8
PB12.Signal=CAN2_RX
PB13.Signal=CAN2_TX
PC1.Signal=ADCx_IN11
PC2.Signal=ADCx_IN12
PC5.Signal=ADCx_IN15
PC6.Signal=USART6_TX
PC7.Signal=USART6_RX
PD0.Signal=CAN1_RX
PD1.Signal=CAN1_TX
PD12.Signal=GPIO_Output
PD13.Signal=GPIO_Output
PD14.Signal=GPIO_Output
PD15.Signal=GPIO_Output
PH0-OSC_IN.Signal=RCC_OSC_IN
PH1-OSC_OUT.Signal=RCC_OSC_OUT
