EmbeddedSystemClass/dynamometer/Ourtasks/adcparams.h

/******************************************************************************
* File Name          : adcparams.h
* Date First Issued  : 03/14/2019
* Board              : DiscoveryF4
* Description        : Parameters for ADC app configuration
*******************************************************************************/
/* CALIBRATION NOTES:

5 volt supply calibration:
[Do this first: This calibration is applied to all 5v sensors]
- Measure 5v supply
- Measure Vdd
- Display ADCsum[5v supply]
Compute--
Ratio 'sensor5vcal' = (Vdd/V5volt) * (ADCsum[5v supply]/(4095*numdmaseq)
 where numdmaseq = number of ADC scans per 1/2 dma (i.e. number readings in sum)

Ratiometric 5v sensor calibration:
- With 5v supply calibration compiled-in:
- Measure Sensor voltage: Vx
- Display:
  . ADCsum[sensor]
  . Va = (V5 * ratio)/ADCsum[5v]
Compute
  Calibration ratio = ADCsum[sensor]/Va
*/

#ifndef __ADCPARAMS
#define __ADCPARAMS

#include "iir_f1.h"
#include "iir_f2.h"

#define ADC1DMANUMSEQ        16 // Number of DMA scan sequences in 1/2 DMA buffer
#define ADC1IDX_ADCSCANSIZE  10 // Number ADC channels read

/* ADC reading sequence/array indices                         */
/* These indices -=>MUST<= match the hardware ADC scan sequence    */
#define ADC1IDX_SPARE         0   // PA0 IN0  - spare
#define ADC1IDX_CURRENTTOTAL  1   // PA5 IN5  - Current sensor: total battery current
#define ADC1IDX_CURRENTMOTOR1 2   // PA6 IN6  - Current sensor: motor #1
#define ADC1IDX_CURRENTMOTOR2 3   // PA7 IN7  - Current sensor: motor #2
#define ADC1IDX_RESISRPOT     4 	 // PB0 IN8  - Speed control pot
#define ADC1IDX_HALLLEVER     5 	 // PC1 IN11 - Torque control level
#define ADC1IDX_12VRAWSUPPLY  6   // PC2 IN12 - +12 Raw power to board
#define ADC1IDX_5VOLTSUPPLY   7   // PC5 IN15 - 5V sensor supply
#define ADC1IDX_INTERNALTEMP  8   //     IN17 - Internal temperature sensor
#define ADC1IDX_INTERNALVREF  9   //     IN18 - Internal voltage reference

/* Calibration option.                                    */
/* Calibration is applied after compensation adjustments. */
#define ADC1PARAM_CALIBTYPE_RAW_F  0    // No calibration applied: FLOAT
#define ADC1PARAM_CALIBTYPE_OFSC   1    // Offset & scale (poly ord 0 & 1): FLOAT
#define ADC1PARAM_CALIBTYPE_POLY2  2    // Polynomial 2nd ord: FLOAT
#define ADC1PARAM_CALIBTYPE_POLY3  3    // Polynomial 3nd ord: FLOAT
#define ADC1PARAM_CALIBTYPE_RAW_UI 4    // No calibration applied: UNSIGNED INT

/* Compensation type                                         */
/* Assumes 5v sensor supply is measured with an ADC channel. */
#define ADC1PARAM_COMPTYPE_NONE      0     // No supply or temp compensation applied
#define ADC1PARAM_COMPTYPE_RATIOVDD  1     // Vdd (3.3v nominal) ratiometric
#define ADC1PARAM_COMPTYPE_RATIO5V   2     // 5v ratiometric with 5->Vdd measurement
#define ADC1PARAM_COMPTYPE_RATIO5VNO 3     // 5v ratiometric without 5->Vdd measurement
#define ADC1PARAM_COMPTYPE_VOLTVDD   4     // Vdd (absolute), Vref compensation applied
#define ADC1PARAM_COMPTYPE_VOLTVDDNO 5     // Vdd (absolute), no Vref compensation applied
#define ADC1PARAM_COMPTYPE_VOLTV5    6     // 5v (absolute), with 5->Vdd measurement applied
#define ADC1PARAM_COMPTYPE_VOLTV5NO  7     // 5v (absolute), without 5->Vdd measurement applied

/* Filter type codes */
#define ADCFILTERTYPE_NONE		0  // Skip filtering
#define ADCFILTERTYPE_IIR1		1  // IIR single pole
#define ADCFILTERTYPE_IIR2		2  // IIR second order

/* Calibrated ADC reading. */
union ADCCALREADING
{
	uint32_t ui;
	 int32_t  n;
	float     f;
};

/* This holds calibration values common to all ADC modules. 
     Some of these are not used.
*/
struct ADCCALCOMMON
{
	// Calibration for external
	float fvddcomp;      // 5->Vdd adjusted factor
	float fvddrecip;     // ?

	float fvddratio;     // Vdd (3.3v) ratiometric constant

	float sensor5vcal;   // The 5v->Vdd divider ratio (e.g. 0.54)
	float sensor5vcalVdd;// The 5v->Vdd divider ratio Vdd adjusted
	float f5_Vddratio;   // (V5volt * Ratio)/ADCsum[5volt supply]
	float f5vsupplyprecal; // 5v supply precalc calibration ratio
	float f5vsupplyprecal_offset; // 5v supply precalc calibration ratio
	float f5vsupply;       // 5v supply
	float f5vsupplyfilt;   // 5v supply, filtered

	// Internal voltage reference
	float vref;          // Vref: 1.18 min, 1.21 typ, 1.24 max
	float tcoef;         // Vref: Temp coefficient (ppm/deg C: 30 typ; 50 max)
	float fvdd;          // Vdd: float (volts)
	float fvddfilt;      // Vdd: float (volts), filtered
	uint16_t ivdd;       // Vdd: fixed (mv)
	uint16_t ts_vref;

	// Internal temperature sensor (floats)
	float ts_cal1;    // Vtemp: TS_CAL1 converted to float ( 30 deg C 3.3v)
	float ts_cal2;    // Vtemp: TS_CAL2 converted to float (110 deg C 3.3v)
	float ts_caldiff; // CAL2-CAL1
	float ts_80caldiff;
	float v25;           // Vtemp: 25 deg C (0.76v typ)
   float slope;         // Vtemp: mv/degC 
	float offset;        // Vtemp: offset
	float degC;          // Temperature: degrees C
	float degCfilt;      // Temperature: degrees C, filtered
 	uint32_t dmact;      // DMA interrupt running counter

	// For integer computation (much faster)
	uint32_t uicaldiff;
	int64_t ll_80caldiff;
	uint32_t ui_cal1;
	uint32_t ui_tmp;
};

struct ADCVTEMPVREF
{
	struct ADCCALCOMMON acc;
	float	vref;         // Latest value of Vref
	float vtemp;        // Latest value of Vtemp
	float degC;         // Temp sensor converted to degC       
	uint64_t u64_vref;  // Summation accumulator: Vref
	uint64_t u64_vtemp; // Summation accumulator: Vtemp
	uint32_t ct;        // Summation counter

};

/* Calibration constants */
#define ADCCALIBSIZE 4 // Number of entries: none - 4th order polynomial
union ADCCALIB
{
	 float    f[ADCCALIBSIZE];
	uint32_t ui[ADCCALIBSIZE];
	 int32_t  n[ADCCALIBSIZE];
};

/* ADC parameters (for one channel): initialized either 
     from 'adcparamsinit.c' or high flash. */
struct ADCPARAM
{
	uint8_t filttype;   // Type of result filtering
	uint8_t calibtype;  // Calibration type
	uint8_t comptype;   // Compensation type
};

/* Intermediate working variables for various filter types. */
union ADCPARAMWORK
{
	struct FILTERIIRF1 iir_f1;	// Filter block for iir_f1
	struct FILTERIIRF2 iir_f2;	// Filter block for iir_f2
};

/* "Everthing" for one ADC channel. */
struct ADCCHANNELSTUFF
{
	struct ADCPARAM xprms;   // ADC fixed parameters
	union  ADCCALIB cal;     // ADC calibrations
	union  ADCPARAMWORK fpw; // ADC filter params and working variables
	uint32_t ctr;            // Update counter
};

/* struct allows pointer to access raw and calibrated ADC1 data. */
struct ADC1DATA
{
  union ADCCALREADING adc1calreading[ADC1IDX_ADCSCANSIZE]; // Calibrated readings
  union ADCCALREADING adc1calreadingfilt[ADC1IDX_ADCSCANSIZE]; // Calibrated readings: filtered
  uint32_t ctr; // Running count of updates.
  uint16_t adcs1sum[ADC1IDX_ADCSCANSIZE]; // Sum of 1/2 DMA buffer for each channel
};

/* *************************************************************************/
void adcparams_init(void);
/*	@brief	: Copy parameters into structs
 * NOTE: => ASSUMES ADC1 ONLY <==
 * *************************************************************************/
void adcparams_internal(struct ADCCALCOMMON* pacom, struct ADC1DATA* padc1);
/*	@brief	: Update values used for compensation from Vref and Temperature
 * @param	: pacom = Pointer calibration parameters for Temperature and Vref
 * @param	: padc1 = Pointer to array of ADC reading sums plus other stuff
 * *************************************************************************/
void adcparams_chan(uint8_t adcidx);
/*	@brief	: calibration, compensation, filtering for channels
 * @param	: adcidx = index into ADC1 array
 * *************************************************************************/

/* Raw and calibrated ADC1 readings. */
extern struct ADC1DATA adc1data;

/* Calibration values common to all ADC modules. */
extern struct ADCCALCOMMON adcommon;

#endif
