EmbeddedSystemClass/dynamometer/(commit log)

2019-02-19 clone routines from mxusartusbcan
    [adcsetup.ods]
2019-02-25 fixed can_iface circlur buffer bug. defaulTask running with usart2. No testing of MailboxTask at this point. Save and backup work.
    [SerialTaskSend.c, can_iface.c, can_iface.h, dynamometer.ioc, main.c]
2019-03-11 save work on filters adc computations.
2019-03-12 save and backup work
    [CP State LEDs.sch, Control Panel High Level.sch, MC Breakout-F4 & Power.sch, MC Brekout-SPInew.sch]
2019-03-16 add adcfastsum16 for adc dma buffer summing
    [adcsetup.ods]
2019-03-19 ADCTask adctask beginning to work. save and backup
    [adcsetup.ods]
2019-03-20 adcparams.c debugging for calibrated Vdd and temperature sensor, floats and ints. floats taking 1500 cycles andi ints 119
    [adcsetup.ods]
2019-04-09 updated from gateway repo. At this point it is the same as gateway. ADC and mailbox work remains to be completed
    [adcsetup.ods]
2019-04-15 dynamometer. ADC routines debug and fixing. Vref, Internal temp, 5v sensor supply, resistor pot calibration working. Currently the strange crash bug is not present. Additional buffers for uart lines 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
    [ADCTask.c, GatewayTask.c, SerialTaskReceive.c, SerialTaskSend.c, adcparams.c, adcparams.h, adcparamsinit.c, adcparamsinit.h]
2019-04-17 iir2 filter work beginning. save and backup
    [iir2.ods]
2019-04-20 second order iir2 experimenting additions
    [iir2.ods, iir2_b.ods, iir2_c.ods]
2019-04-23 main has test code in defaultTask for testing iir2_f2.c
    [iir2.ods, iir2_b.ods, iir2_c.ods, iir2_d.ods]
2019-04-23 dynamometer iface.c configured for CAN abort failure. Reference to ST
    [can_iface.c, main.c]
